FinneganThompson/Tip_Etcher_Rev_3/Docs/Planning/Requirements.md

# Tip Etcher Electronics Requirements

    ## Output Switching
        As measured from the time input at the comparator dropping below the threshold setpoint to the time the ouptut voltage is at or below 0.9V, the Cutoff Time shall be no longer than 50ns. 

    ## Analog Etching Current Measurement

    ## Analog Etching Waveform Amplification

    ## Digital Section

        ### Digital Etching Waveform Synthesis

        ### Threshold Setting

        ### Analog Readback

        ### Interface

    ## Ancillary Components

        ### Power Supply

## Tip Etcher Mechanical Requirements
