FinneganThompson/Tip_Etcher_Rev_3/Electronics/R2_lib/AD603ARZ/R_8_ADI.step

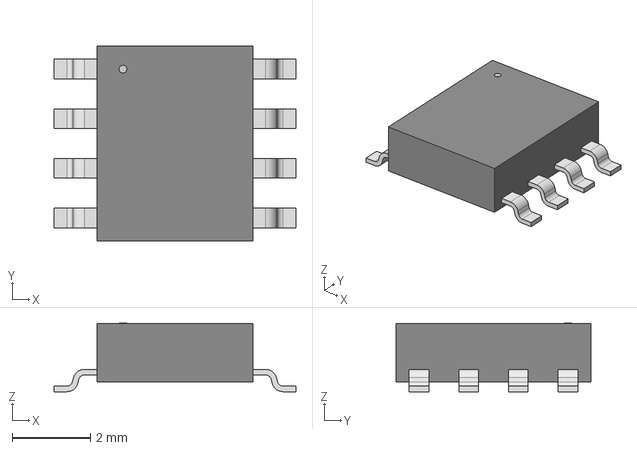
[picture p1: CAD file, 2026-10-09]
Electronics/R2_lib/AD603ARZ/R_8_ADI.step
6.20 x 5.00 x 1.75 mm
