FinneganThompson/Tip_Etcher_Rev_3/Electronics/R2_lib/D0008A.stp

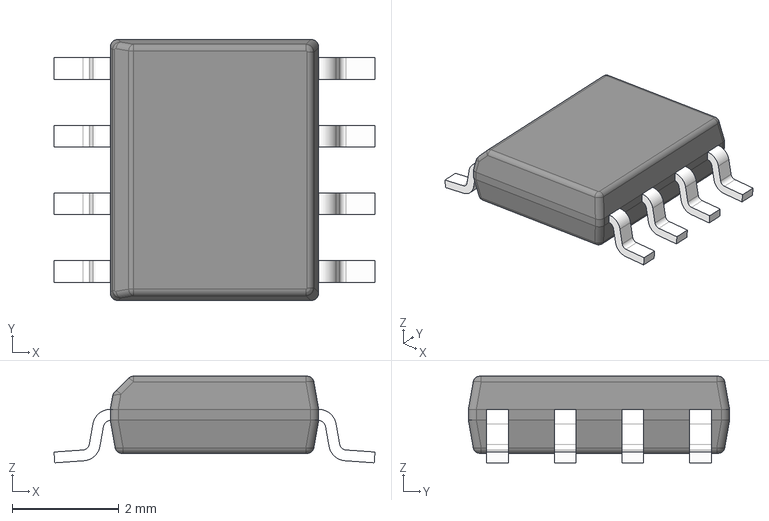
[picture p2: CAD file, 2026-10-09]
Electronics/R2_lib/D0008A.stp
6.02 x 4.90 x 1.63 mm
BODY-SO
LEAD-D0008A x 8
