FinneganThompson/Tip_Etcher_Rev_3/Electronics/R2_lib/LM219DT/SO-14_STM.step

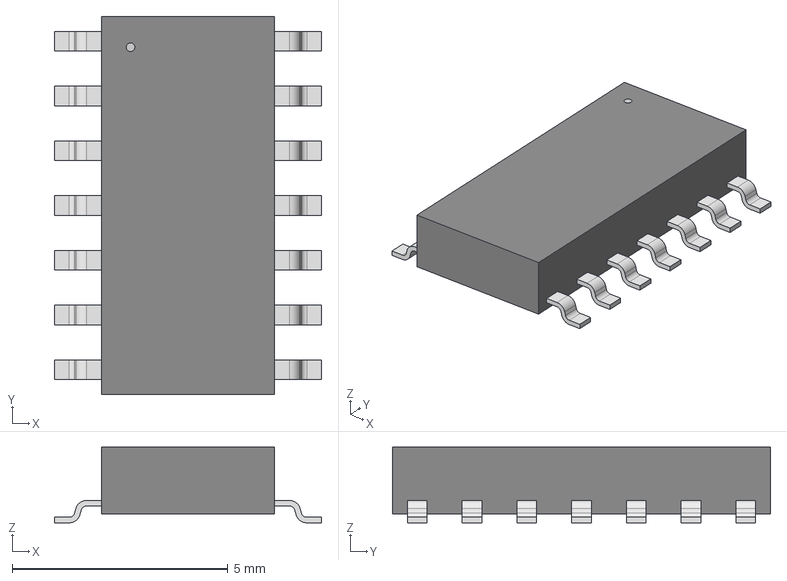
[picture p3: CAD file, 2026-10-09]
Electronics/R2_lib/LM219DT/SO-14_STM.step
6.20 x 8.76 x 1.75 mm
