FinneganThompson/Tip_Etcher_Rev_3/Electronics/Tip_Etcher_Rev_3.pdf

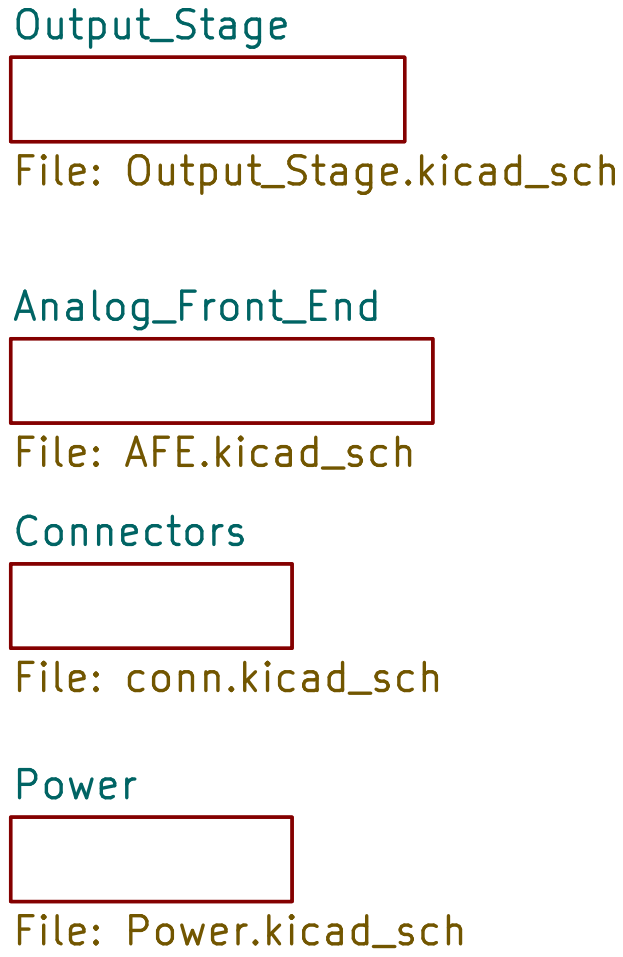
[picture p4: page 1]

Power File: Power.kicad_sch Analog_Front_End File: AFE.kicad_sch Output_Stage File: Output_Stage.kicad_sch Connectors File: conn.kicad_sch

Id: 1/5 Title: File: Tip_Etcher_Rev_2.kicad_sch Sheet: /

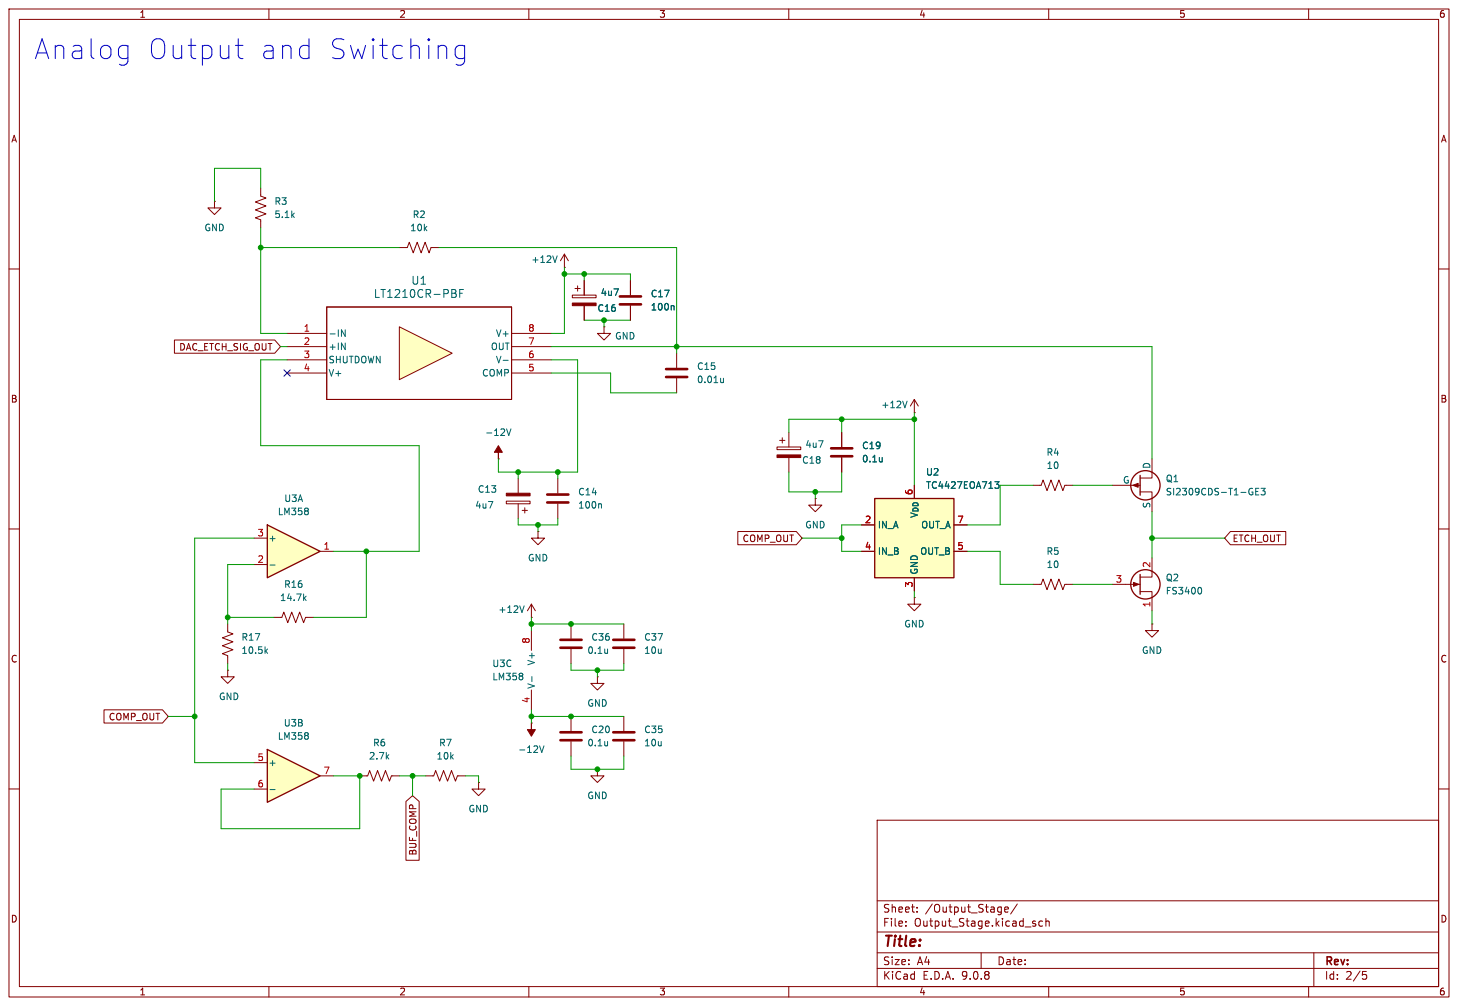
[picture p5: page 2]

D S Q1 SI2309CDS-T1-GE3 +12V C37
Id: 2/5 Title: File: Output_Stage.kicad_sch Sheet: /Output_Stage/ C13

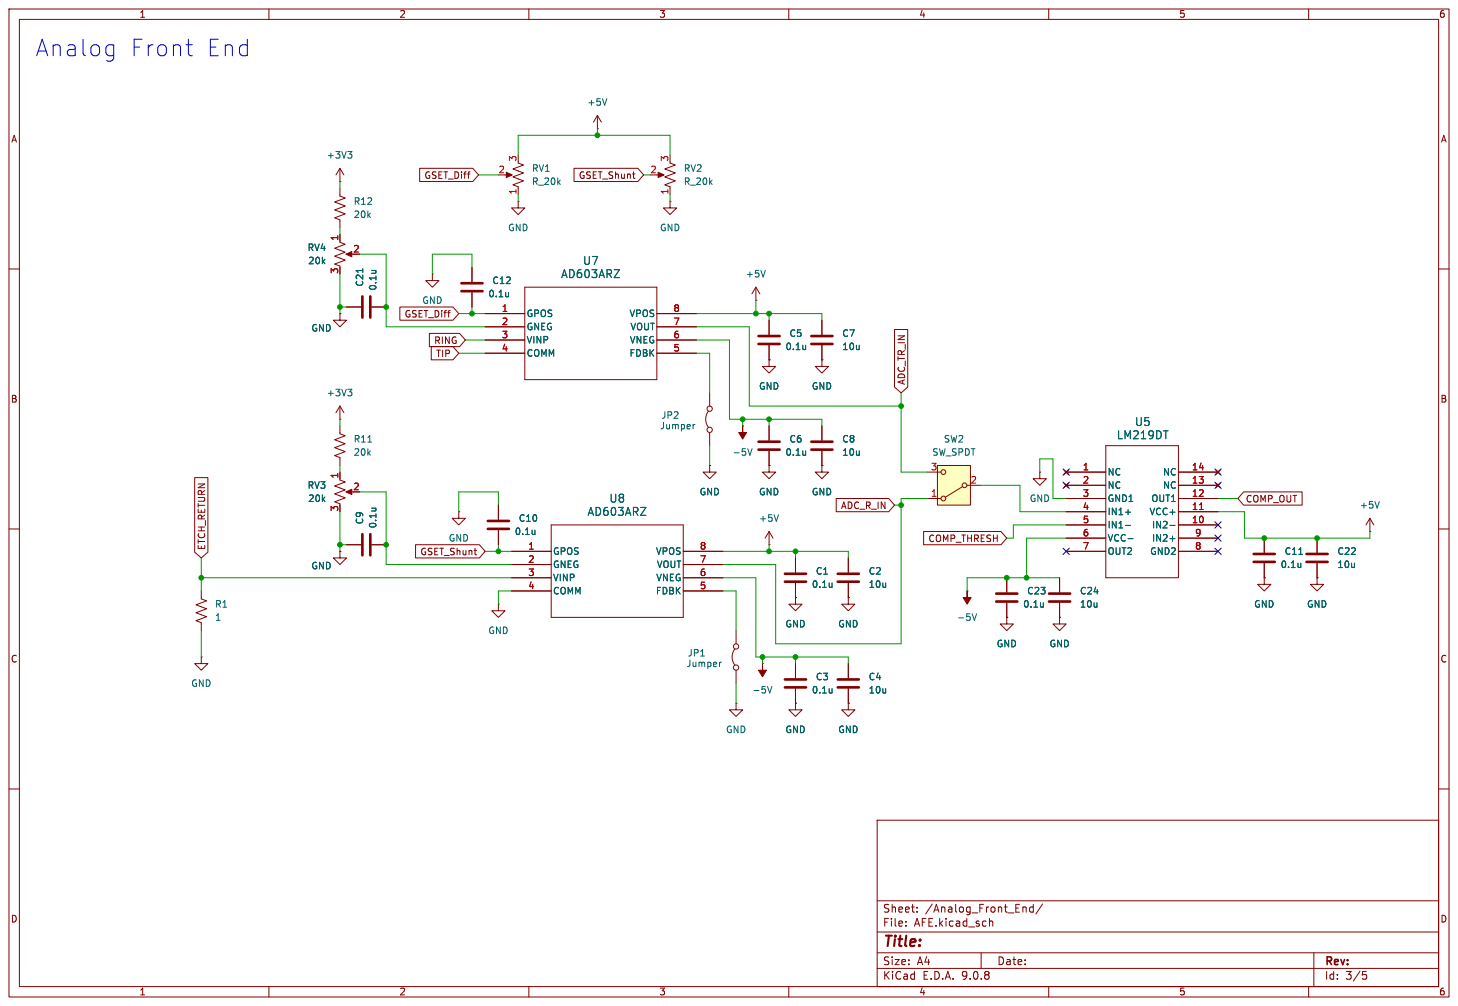
[picture p6: page 3]

Id: 3/5 Title: File: AFE.kicad_sch Sheet: /Analog_Front_End/ C10

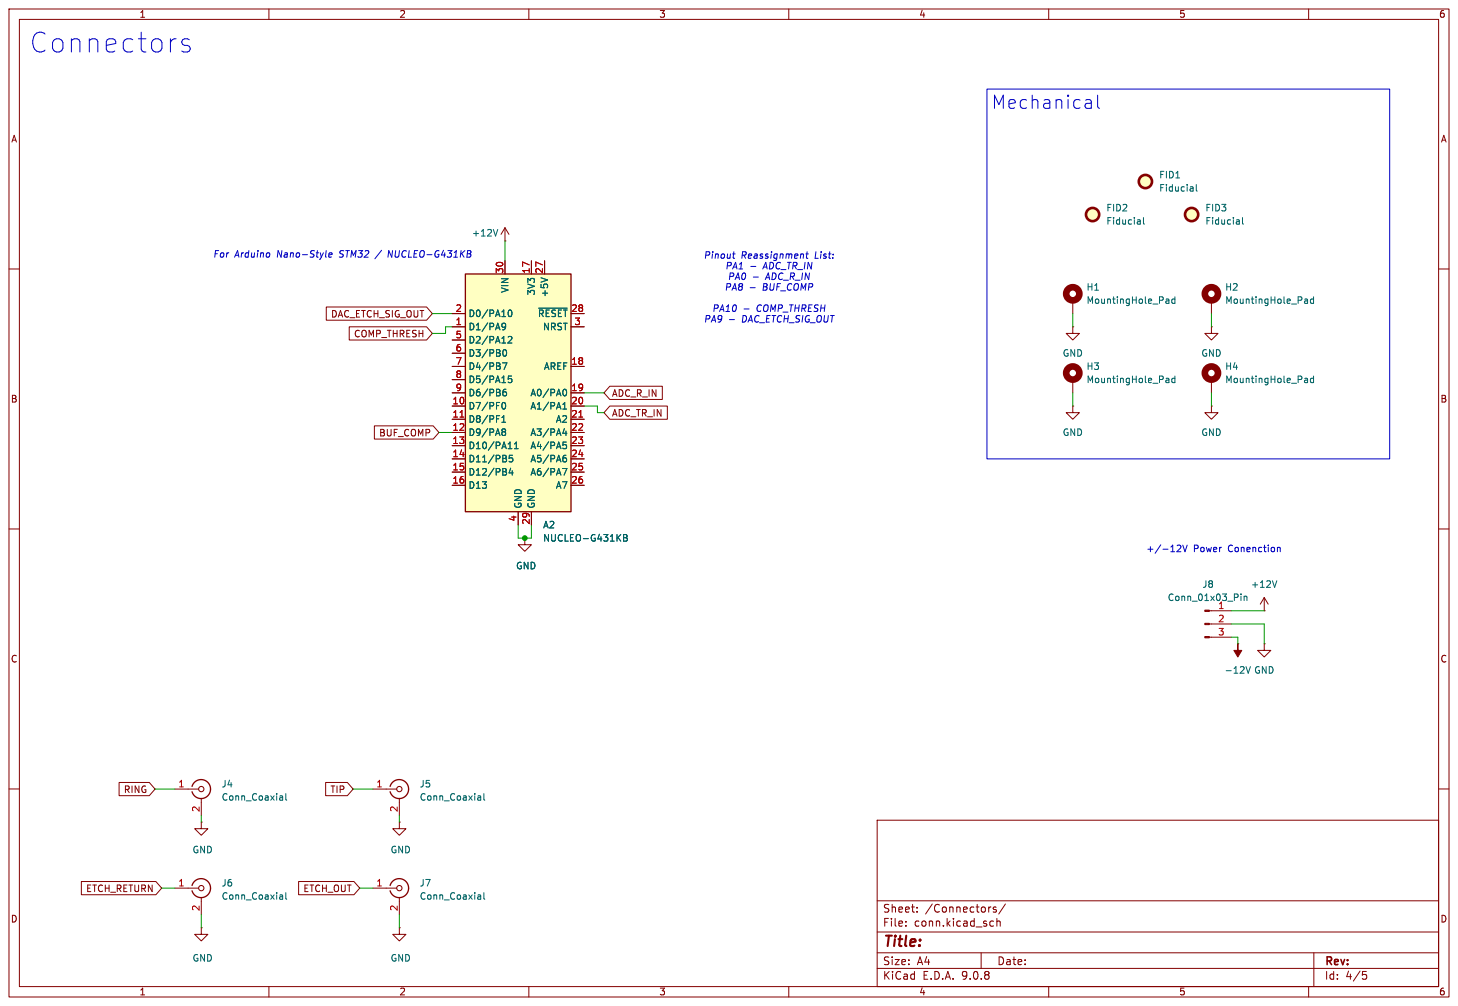
[picture p7: page 4]

Id: 4/5 Title: File: conn.kicad_sch Sheet: /Connectors/

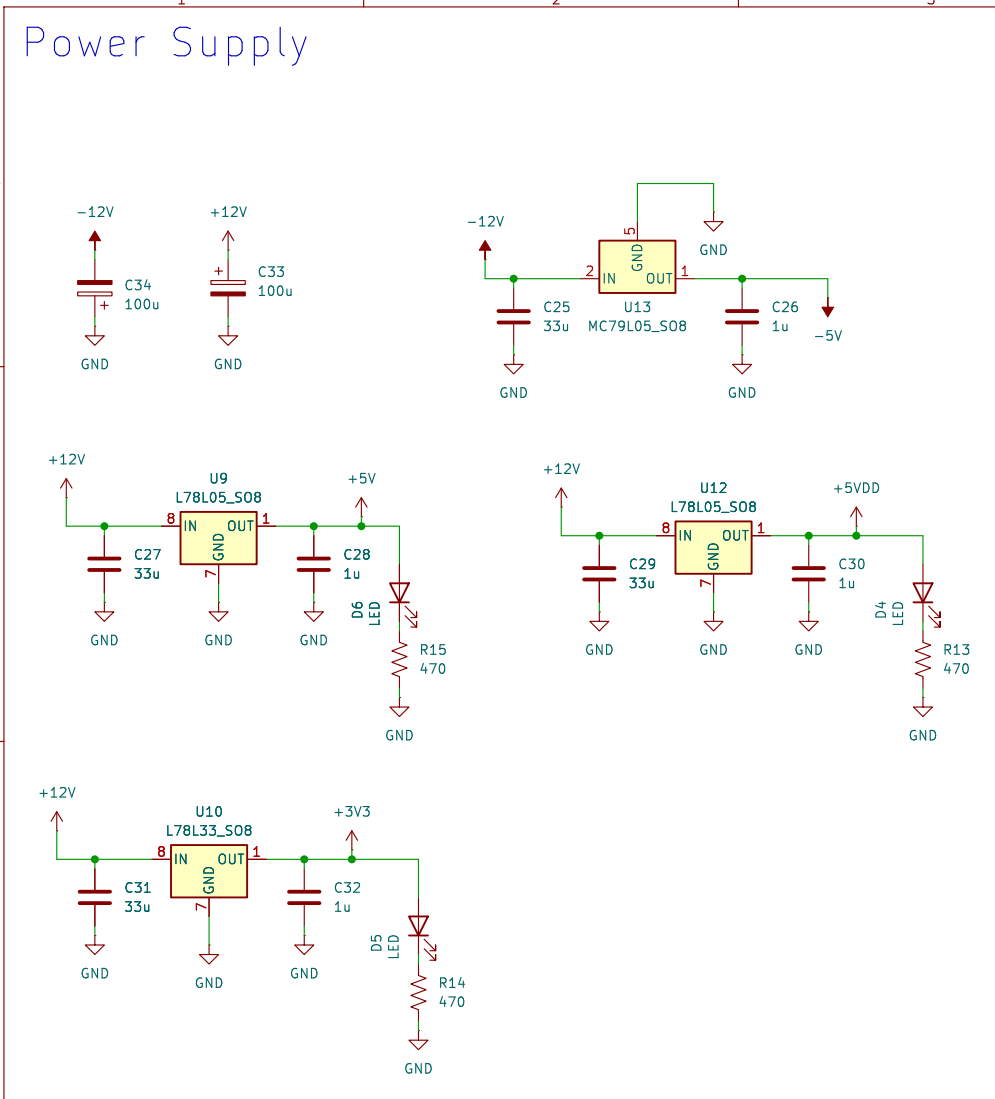
[picture p8: page 5]

33u D6 LED
Id: 5/5 Title: File: Power.kicad_sch Sheet: /Power/ D6 LED
