FinneganThompson/Tip_Etcher_Rev_3/Electronics/Tip_Etcher_Rev_3/Tip_Etcher_Rev_2.kicad_pcb

## KiCad design Electronics/Tip_Etcher_Rev_3/Tip_Etcher_Rev_2.kicad_pcb (2026-10-09)

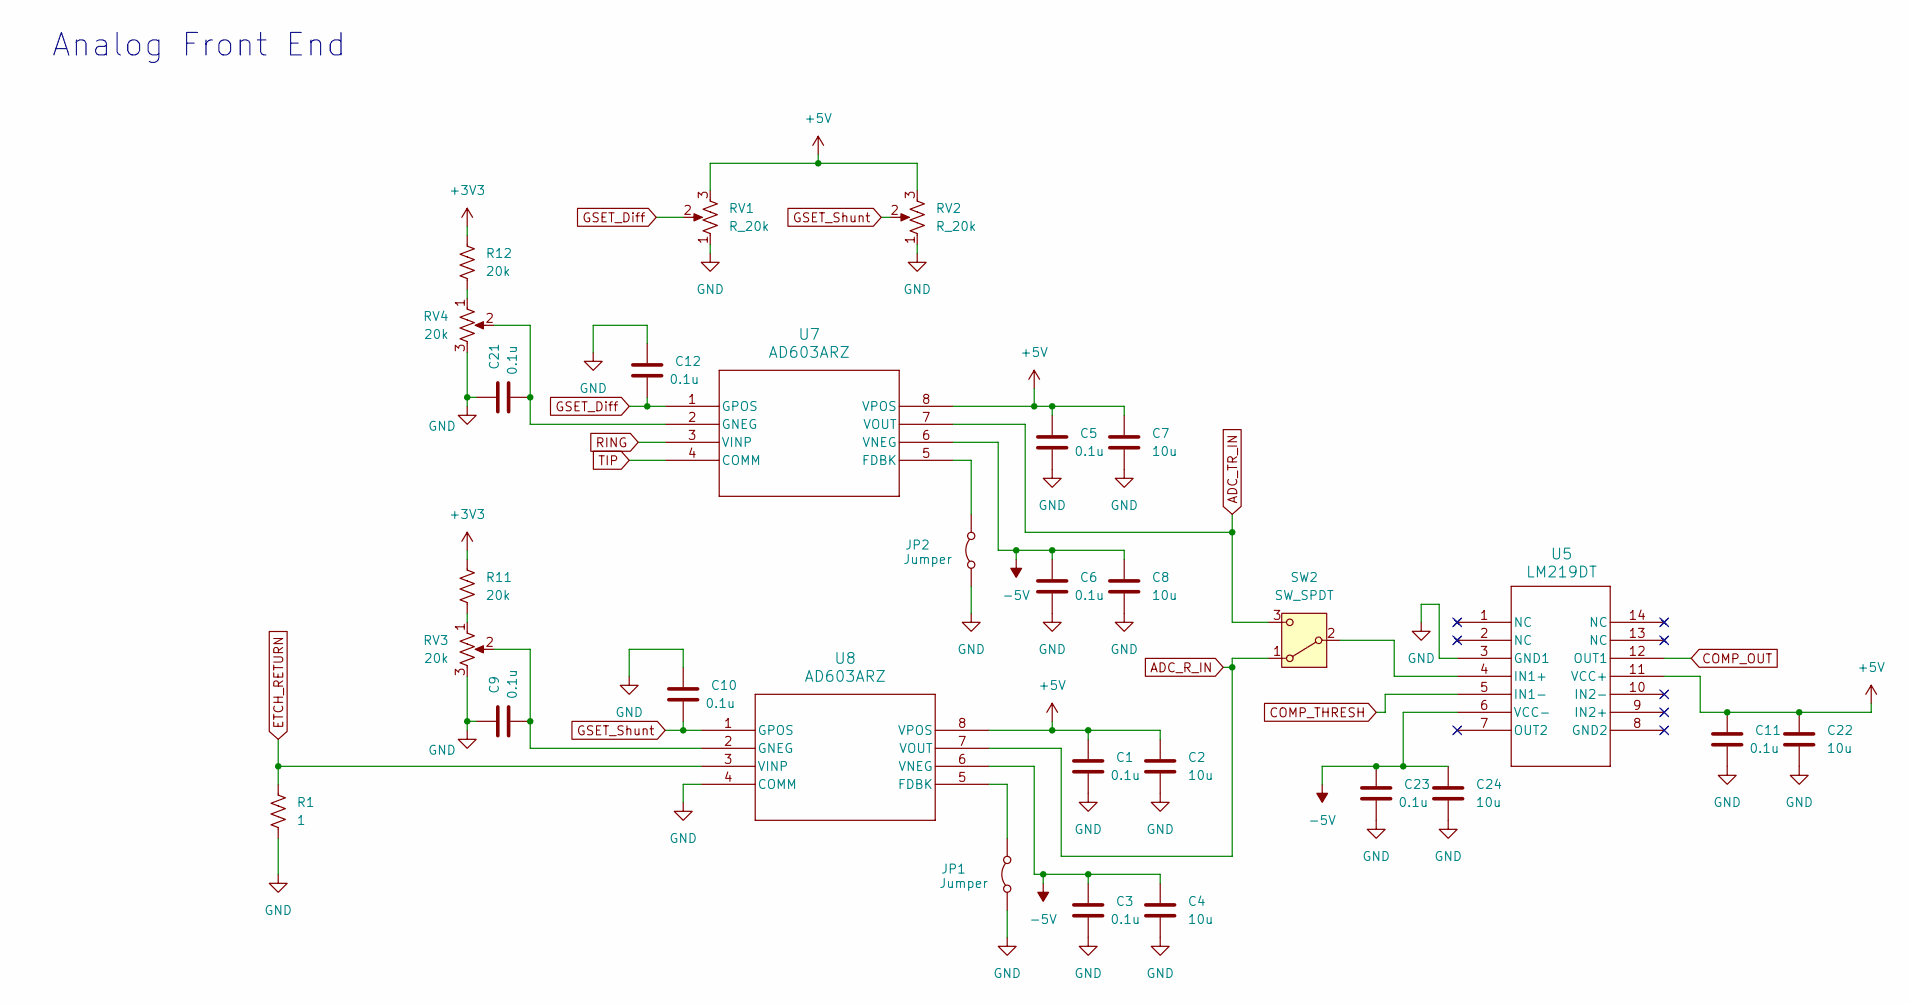
[picture p9: schematic AFE.kicad_sch]

Parts:
C1, C5, C6, C9, C10, C11, C12, C21, C23: 0.1u; C_0603_1608Metric
C2, C7, C8, C22, C24: 10u; C_1206_3216Metric_Pad1.33x1.80mm_HandSolder
C3: 0.1u; C_1206_3216Metric_Pad1.33x1.80mm_HandSolder
C4: 10u; C_0603_1608Metric
JP1, JP2: Jumper; SolderJumper-2_P1.3mm_Bridged2Bar_Pad1.0x1.5mm
R1: 1; R_1812_4532Metric
R11, R12: 20k; R_0603_1608Metric
RV1, RV2: R_20k; Potentiometer_Bourns_3296Y_Vertical
RV3, RV4: 20k; Potentiometer_Bourns_3296Y_Vertical
SW2: SW_SPDT; SW_SPDT_CK_JS102011SAQN
U5: LM219DT; SO-14_3.9x8.65mm_P1.27mm
U7, U8: AD603ARZ; SOIC-8_3.9x4.9mm_P1.27mm

Connections:
+3V3: R11.1, R12.1; also elsewhere on the board
+5V: C1.1, C2.1, C5.1, C7.1, C11.1, C22.1, RV1.3, RV2.3, U5.11 (VCC+), U7.8 (VPOS), U8.8 (VPOS); also elsewhere on the board
-5V: C3.1, C4.1, C6.1, C8.1, C23.1, C24.1, U5.6 (VCC-), U7.6 (VNEG), U8.6 (VNEG); also elsewhere on the board
ADC_R_IN: SW2.1 (A), U8.7 (VOUT); also elsewhere on the board
ADC_TR_IN: SW2.3 (C), U7.7 (VOUT); also elsewhere on the board
COMP_OUT: U5.12 (OUT1); also elsewhere on the board
COMP_THRESH: U5.5 (IN1-); also elsewhere on the board
ETCH_RETURN: R1.1, U8.3 (VINP); also elsewhere on the board
GND: C1.2, C2.2, C3.2, C4.2, C5.2, C6.2, C7.2, C8.2, C9.1, C10.1, C11.2, C12.1, C21.1, C22.2, C23.2, C24.2, JP1.1 (A), JP2.1 (A), R1.2, RV1.1, RV2.1, RV3.3, RV4.3, U5.3 (GND1), U8.4 (COMM); also elsewhere on the board
GSET_Diff: C12.2, RV1.2, U7.1 (GPOS)
GSET_Shunt: C10.2, RV2.2, U8.1 (GPOS)
unnamed: JP1.2 (B), U8.5 (FDBK)
unnamed: JP2.2 (B), U7.5 (FDBK)
unnamed: R11.2, RV3.1
unnamed: R12.2, RV4.1
unnamed: SW2.2 (B), U5.4 (IN1+)
unnamed: C21.2, RV4.2, U7.2 (GNEG)
unnamed: C9.2, RV3.2, U8.2 (GNEG)
RING: U7.3 (VINP); also elsewhere on the board
TIP: U7.4 (COMM); also elsewhere on the board

Notes on the sheet:
Analog Front End

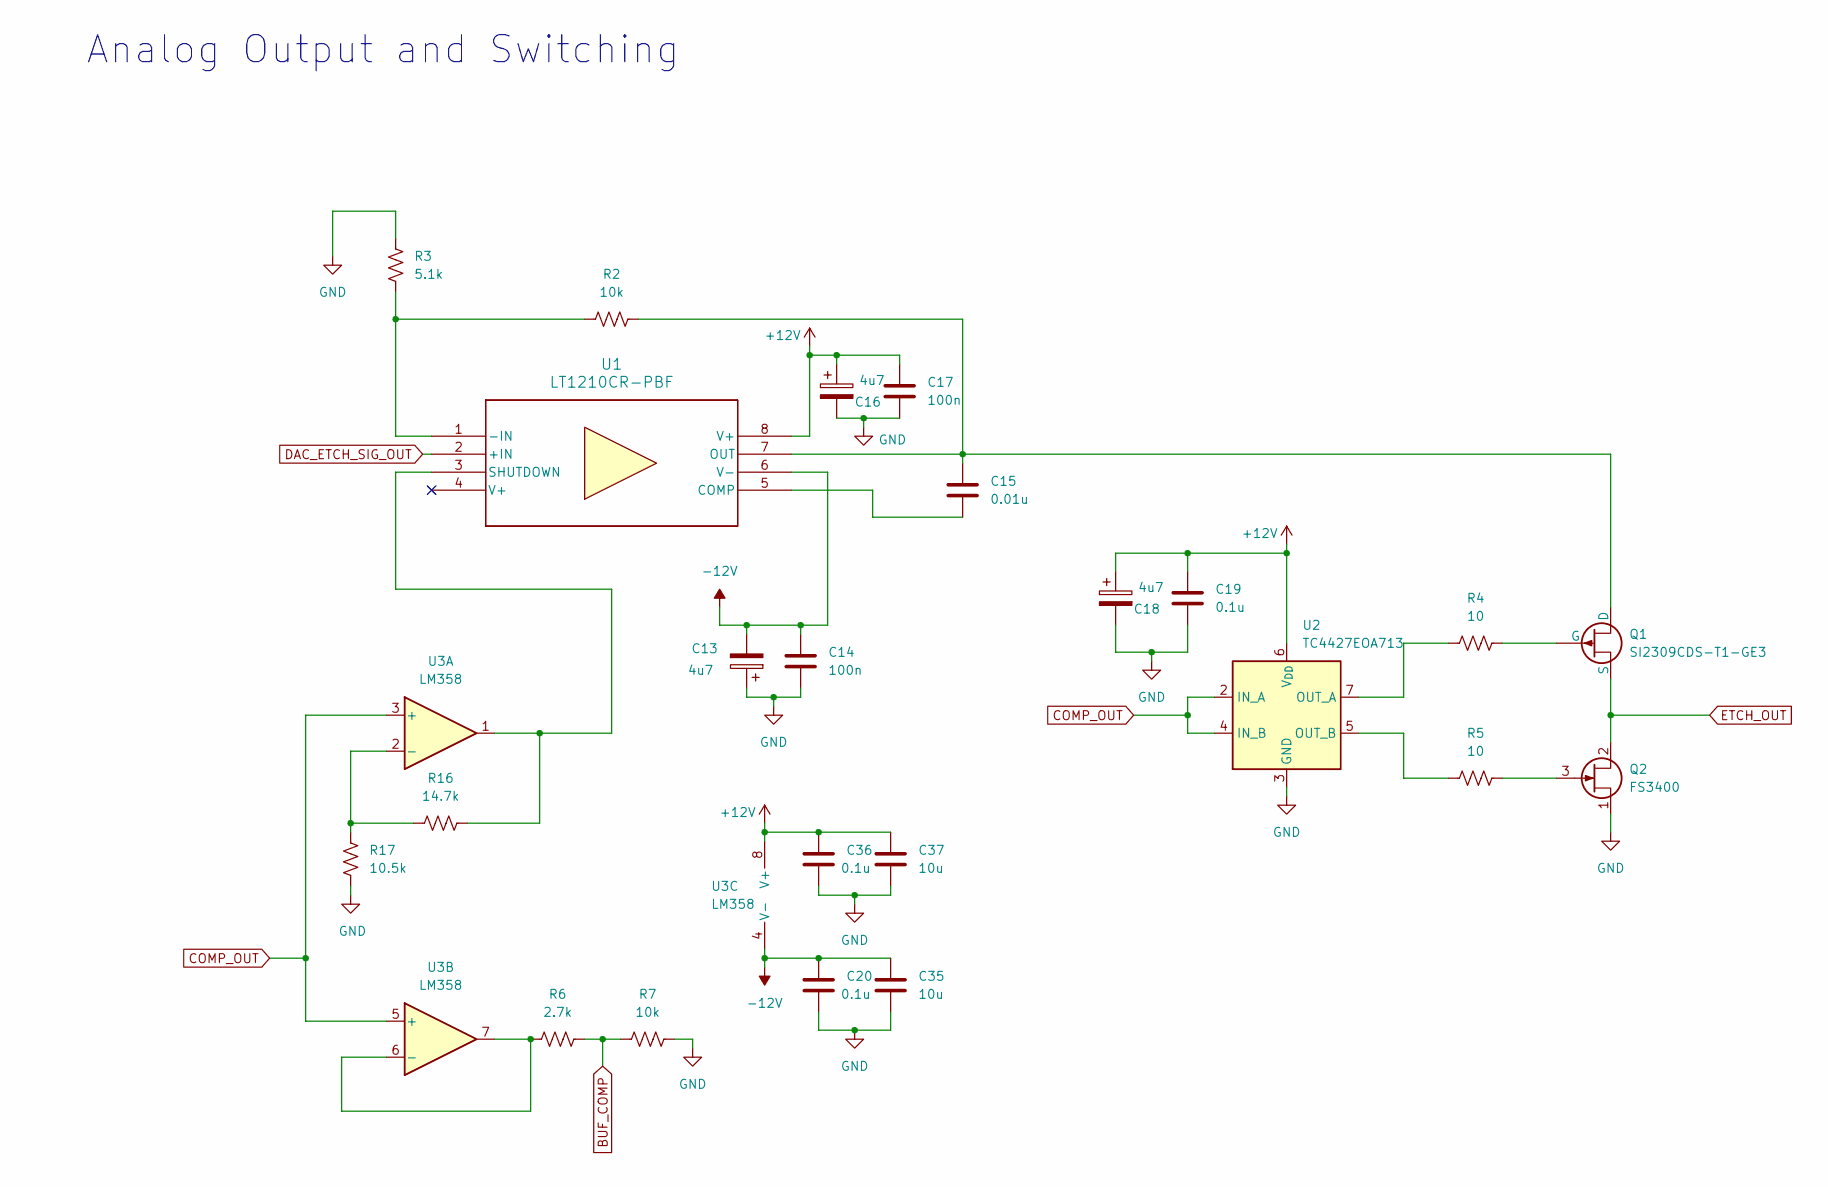
[picture p10: schematic Output_Stage.kicad_sch]

Parts:
C13, C16, C18: 4u7; C_Elec_3x5.4
C14, C17: 100n; C_0603_1608Metric
C15: 0.01u; C_0603_1608Metric
C19, C20, C36: 0.1u; C_0603_1608Metric
C35, C37: 10u; C_0603_1608Metric
Q1: SI2309CDS-T1-GE3; SOT-23
Q2: FS3400; SOT-23
R2, R7: 10k; R_0603_1608Metric
R3: 5.1k; R_0603_1608Metric
R4, R5: 10; R_0603_1608Metric
R6: 2.7k; R_0603_1608Metric
R16: 14.7k; R_0603_1608Metric
R17: 10.5k; R_0603_1608Metric
U1: LT1210CR-PBF; TO-263-7_TabPin8
U2: TC4427EOA713; SOIC-8_3.9x4.9mm_P1.27mm
U3: LM358; SOIC-8-1EP_3.9x4.9mm_P1.27mm_EP2.29x3mm

Connections:
+12V: C16.1, C17.1, C18.1, C19.1, C36.1, C37.1, U1.8 (V+), U2.6 (V_{DD}), U3.8 (V+); also elsewhere on the board
-12V: C13.2, C14.1, C20.1, C35.1, U1.6 (V-), U3.4 (V-); also elsewhere on the board
BUF_COMP: R6.2, R7.1; also elsewhere on the board
COMP_OUT: U2.2 (IN_A), U2.4 (IN_B), U3.3 (+), U3.5 (+); also elsewhere on the board
DAC_ETCH_SIG_OUT: U1.2 (+IN); also elsewhere on the board
ETCH_OUT: Q1.3 (S), Q2.2 (D); also elsewhere on the board
GND: C13.1, C14.2, C16.2, C17.2, C18.2, C19.2, C20.2, C35.2, C36.2, C37.2, Q2.1 (S), R3.2, R7.2, R17.1, U2.3 (GND); also elsewhere on the board
unnamed: C15.1, Q1.1 (D), R2.2, U1.7 (OUT)
unnamed: Q1.2 (G), R4.1
unnamed: Q2.3 (G), R5.1
unnamed: R2.1, R3.1, U1.1 (-IN)
unnamed: C15.2, U1.5 (COMP)
unnamed: R16.2, U1.3 (SHUTDOWN), U3.1
unnamed: R4.2, U2.7 (OUT_A)
unnamed: R5.2, U2.5 (OUT_B)
unnamed: R16.1, R17.2, U3.2 (-)
unnamed: R6.1, U3.6 (-), U3.7

Notes on the sheet:
Analog Output and Switching

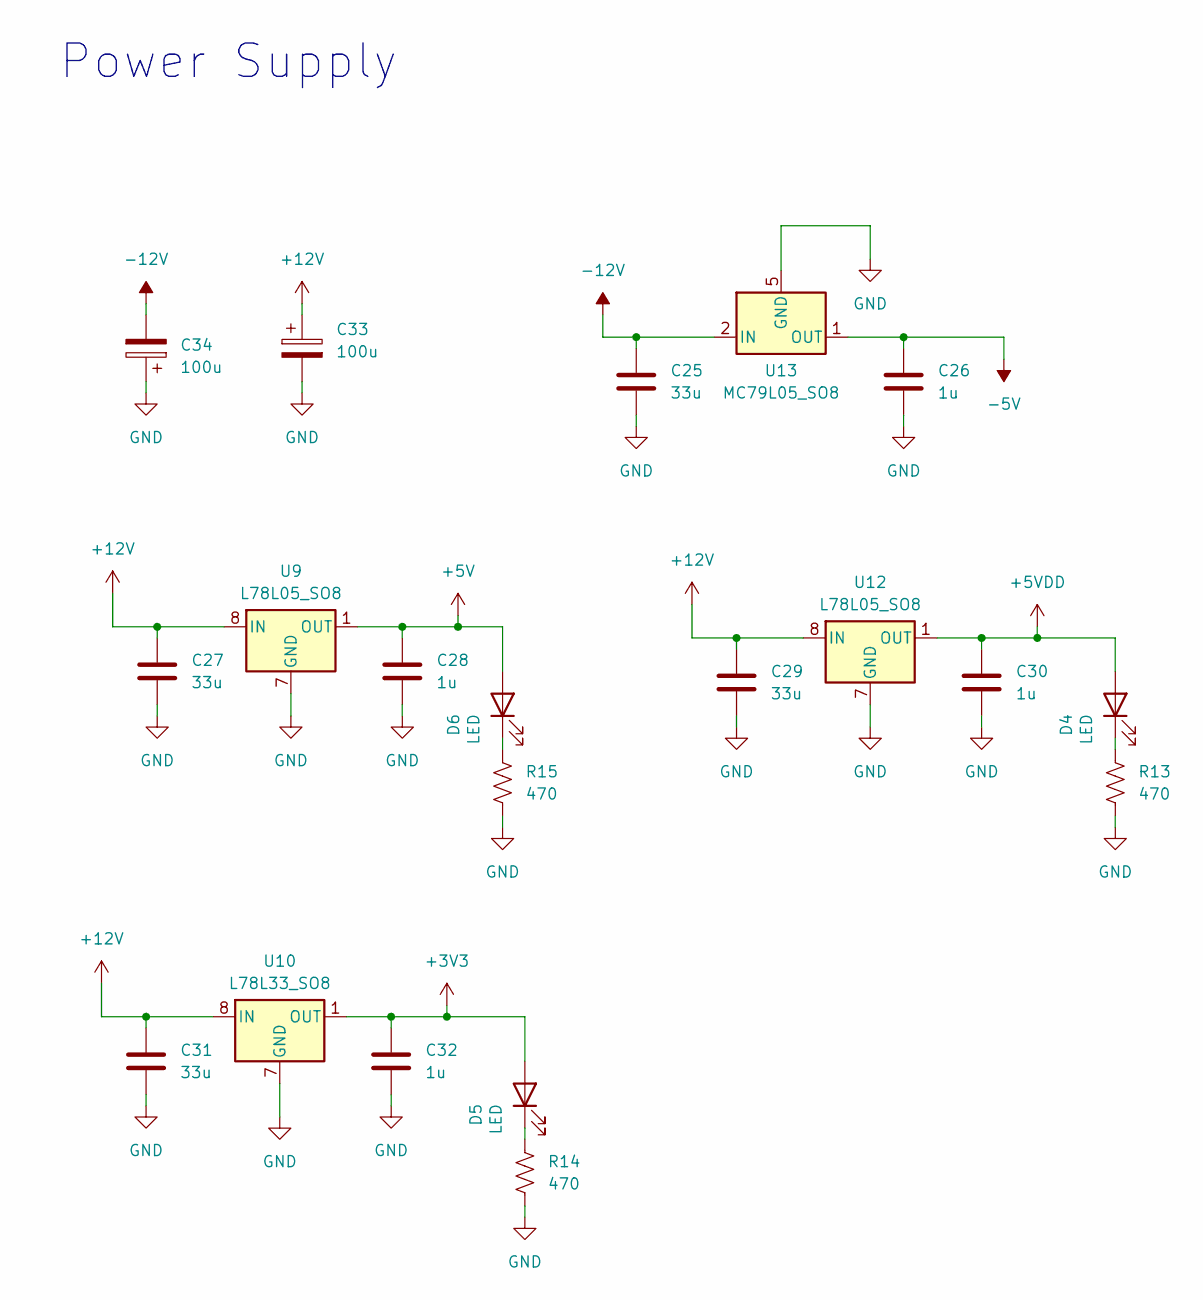
[picture p11: schematic Power.kicad_sch]

Parts:
C25, C27, C29, C31: 33u; C_1206_3216Metric_Pad1.33x1.80mm_HandSolder
C26, C28, C30, C32: 1u; C_0603_1608Metric
C33, C34: 100u; C_Elec_3x5.4
D4, D5, D6: LED; LED_0805_2012Metric
R13, R14, R15: 470; R_0603_1608Metric
U9, U12: L78L05_SO8; SOIC-8_3.9x4.9mm_P1.27mm
U10: L78L33_SO8; SOIC-8_3.9x4.9mm_P1.27mm
U13: MC79L05_SO8; SOIC-8_3.9x4.9mm_P1.27mm

Connections:
+3V3: C32.1, D5.2 (A), U10.1 (OUT); also elsewhere on the board
+5V: C28.1, D6.2 (A), U9.1 (OUT); also elsewhere on the board
+5VDD: C30.1, D4.2 (A), U12.1 (OUT)
+12V: C27.1, C29.1, C31.1, C33.1, U9.8 (IN), U10.8 (IN), U12.8 (IN); also elsewhere on the board
-5V: C26.1, U13.1 (OUT); also elsewhere on the board
-12V: C25.1, C34.2, U13.2 (IN), U13.3 (IN), U13.6 (IN), U13.7 (IN); also elsewhere on the board
GND: C25.2, C26.2, C27.2, C28.2, C29.2, C30.2, C31.2, C32.2, C33.2, C34.1, R13.2, R14.2, R15.2, U9.7 (GND), U10.7 (GND), U12.7 (GND), U13.5 (GND); also elsewhere on the board
unnamed: D4.1 (K), R13.1
unnamed: D5.1 (K), R14.1
unnamed: D6.1 (K), R15.1

Notes on the sheet:
Power Supply

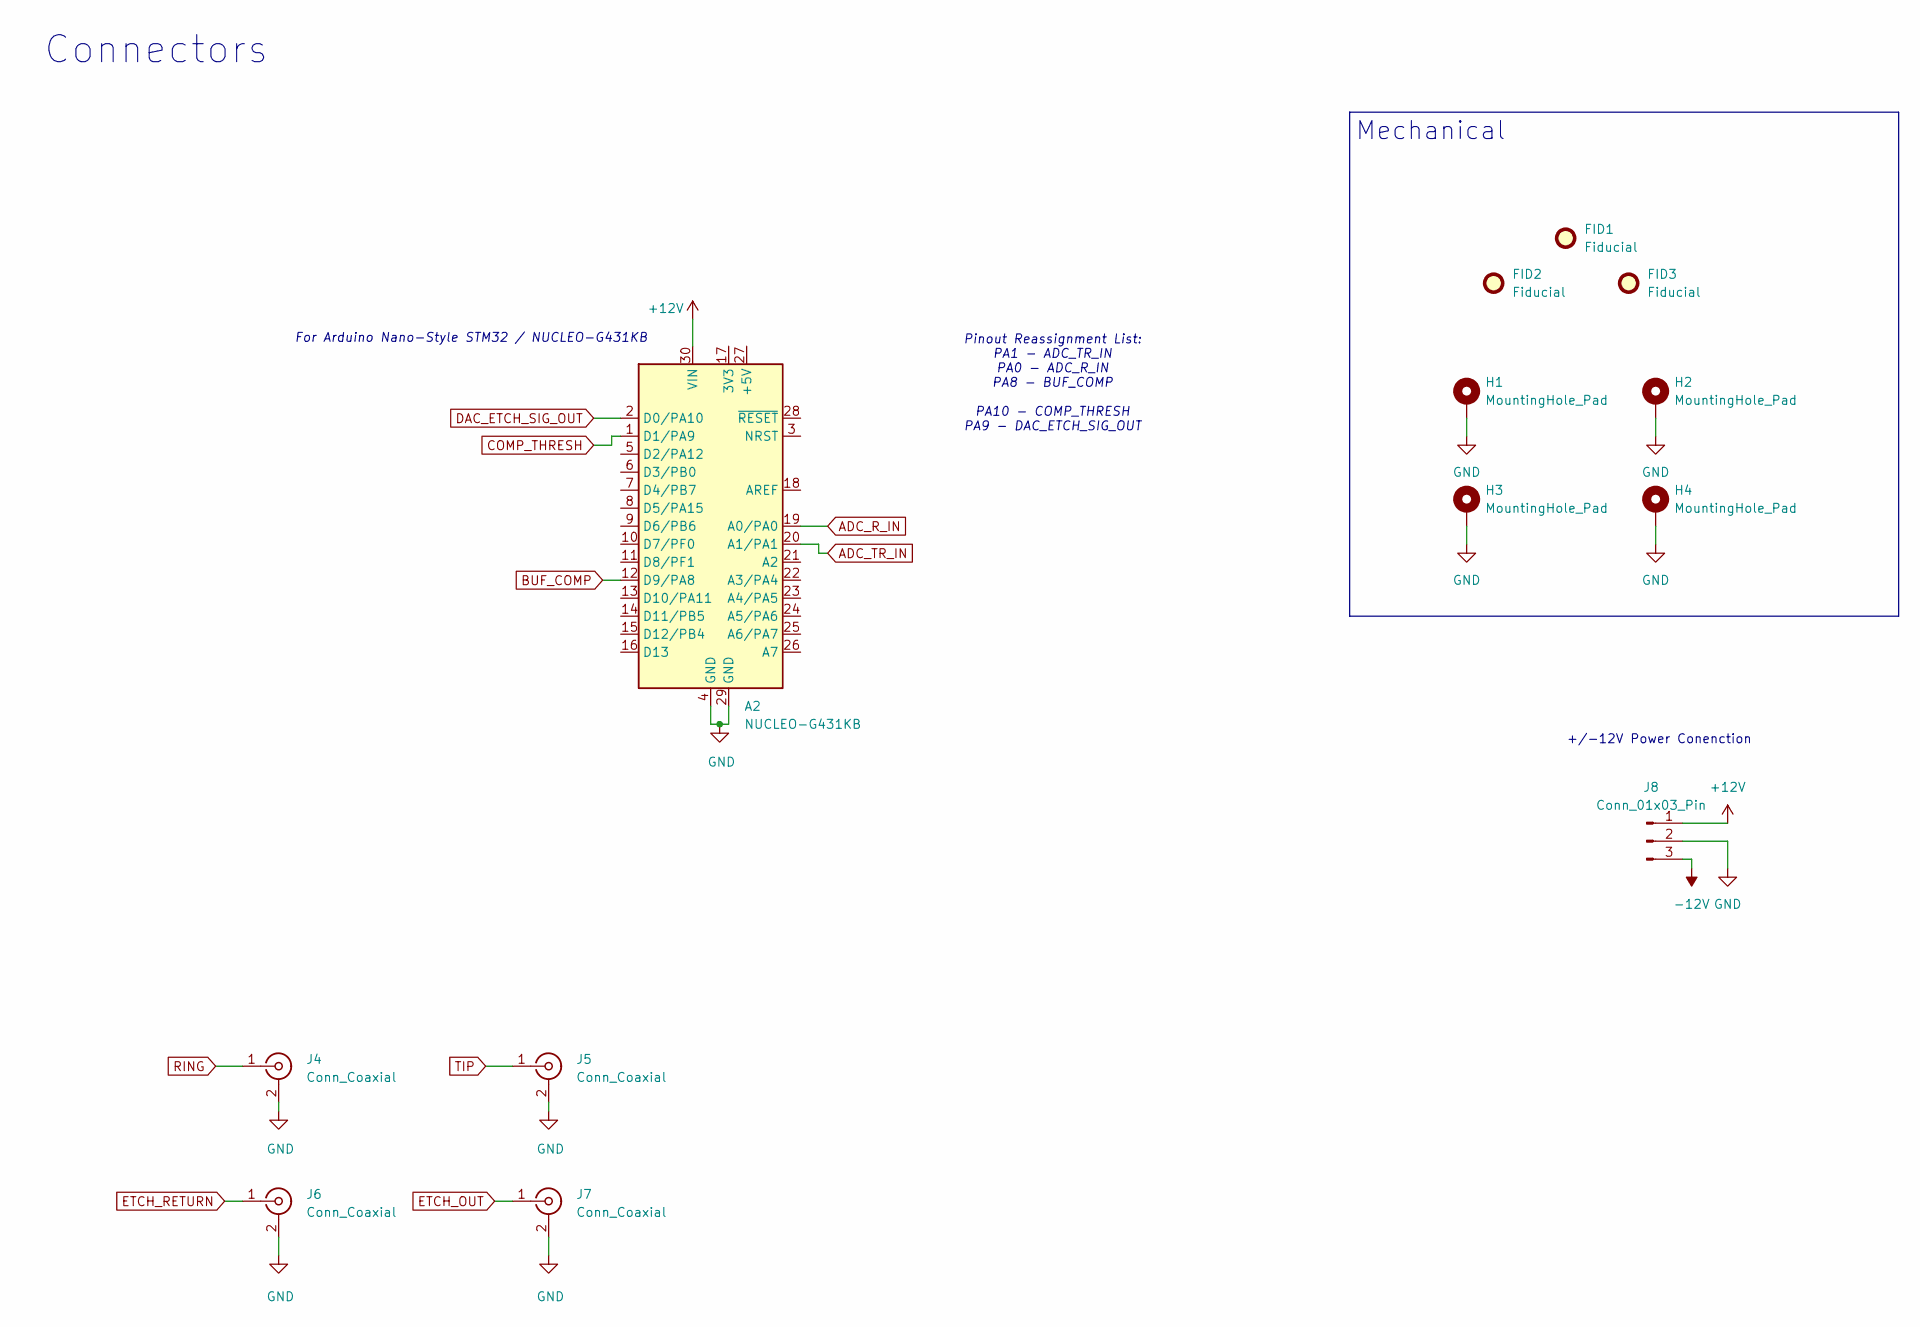
[picture p12: schematic conn.kicad_sch]

Parts:
A2: NUCLEO-G431KB; Arduino_Nano
FID1, FID2, FID3: Fiducial; Fiducial_0.5mm_Mask1mm
H1, H2, H3, H4: MountingHole_Pad; MountingHole_4.3mm_M4_ISO14580_Pad_TopOnly
J4, J5, J6, J7: Conn_Coaxial; LINX_CONBNC002
J8: Conn_01x03_Pin; TerminalBlock_Phoenix_MKDS-1,5-3_1x03_P5.00mm_Horizontal

Connections:
+12V: A2.30 (VIN), J8.1; also elsewhere on the board
-12V: J8.3; also elsewhere on the board
ADC_R_IN: A2.19 (A0/PA0); also elsewhere on the board
ADC_TR_IN: A2.20 (A1/PA1); also elsewhere on the board
BUF_COMP: A2.12 (D9/PA8); also elsewhere on the board
COMP_THRESH: A2.1 (D1/PA9); also elsewhere on the board
DAC_ETCH_SIG_OUT: A2.2 (D0/PA10); also elsewhere on the board
ETCH_OUT: J7.1 (In); also elsewhere on the board
ETCH_RETURN: J6.1 (In); also elsewhere on the board
GND: A2.4 (GND), A2.29 (GND), H1.1, H2.1, H3.1, H4.1, J4.2 (Ext), J5.2 (Ext), J6.2 (Ext), J7.2 (Ext), J8.2; also elsewhere on the board
RING: J4.1 (In); also elsewhere on the board
TIP: J5.1 (In); also elsewhere on the board

Notes on the sheet:
Connectors
+/-12V Power Conenction
Mechanical
Pinout Reassignment List: PA1 - ADC_TR_IN PA0 - ADC_R_IN PA8 - BUF_COMP PA10 - COMP_THRESH PA9 - DAC_ETCH_SIG_OUT
For Arduino Nano-Style STM32 / NUCLEO-G431KB

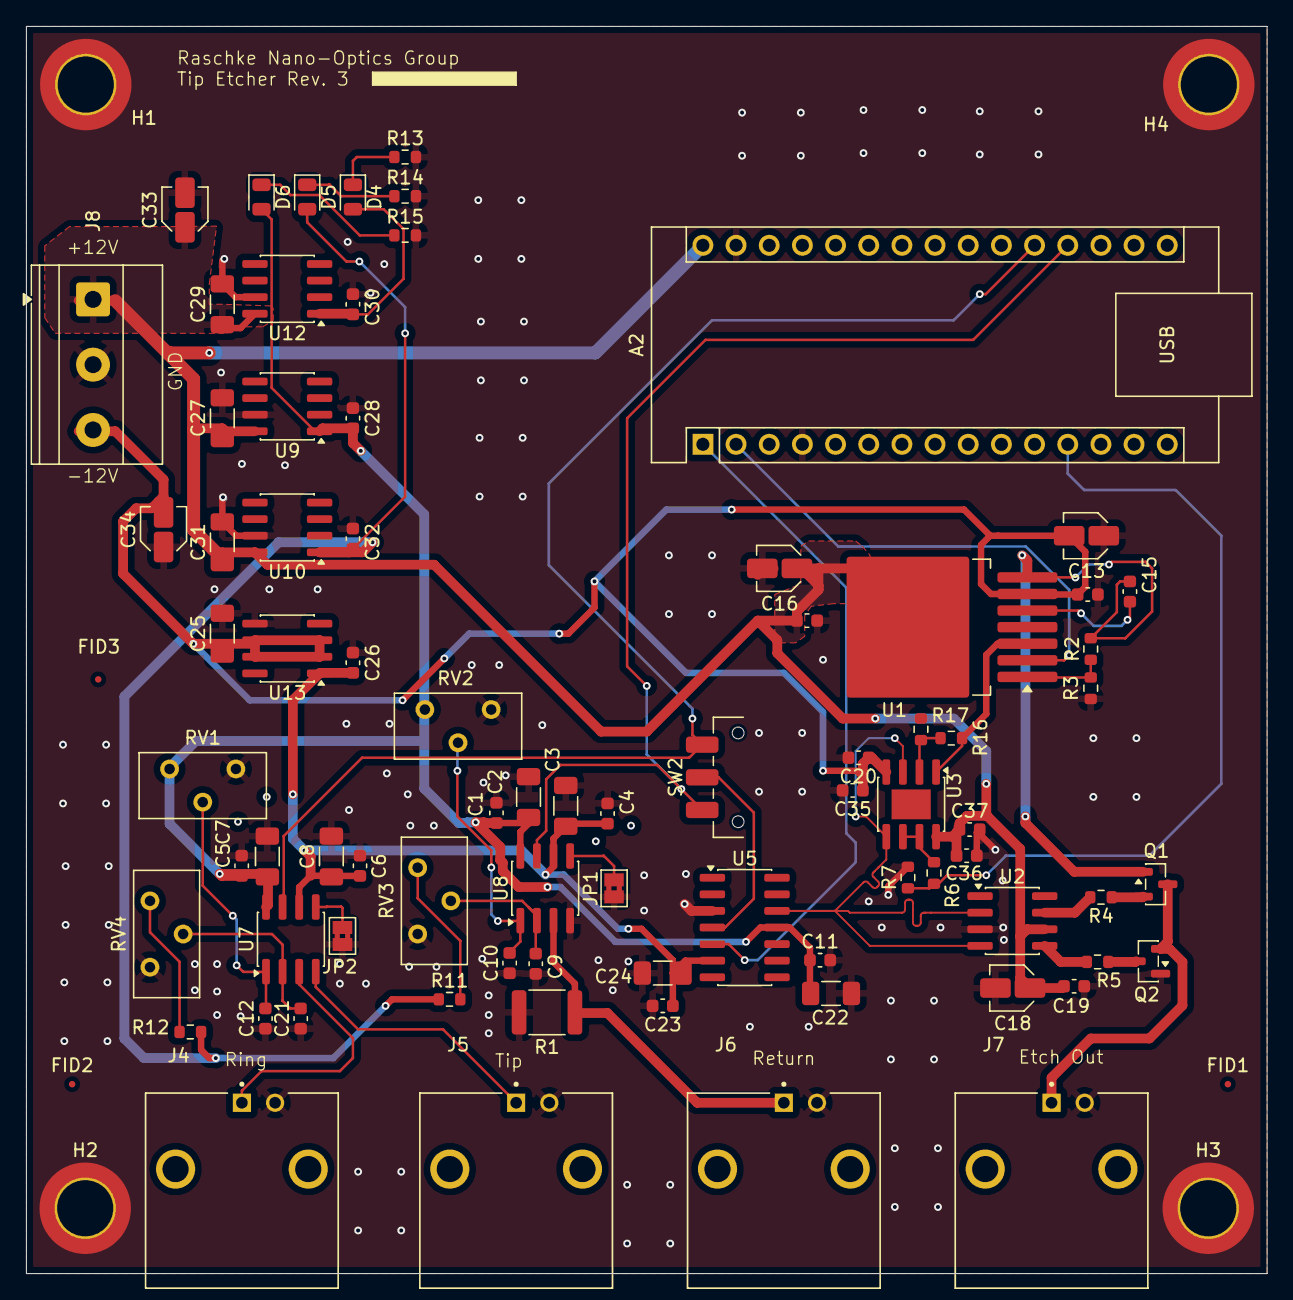
[picture p13: board Tip_Etcher_Rev_2.kicad_pcb from above]

Board: 2 copper layers, 95.0 x 95.5 mm, 86 parts (0 on the bottom side), 39 nets.
