FinneganThompson/Tip_Etcher_Rev_3/(commit log)

2026-10-09 added cad files
    [AFE.kicad_sch, BOM-Tip_Etcher_Rev_2.csv, D0008A.stp, Output_Stage.kicad_sch, Power.kicad_sch, R_8_ADI.step, SO-14_STM.step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]
2026-10-09 added schematic pdf
2026-10-09 Update README.md - added stm pin mapping
